Boble8080/Self-Balancing-Robot/encoderWaveform.png

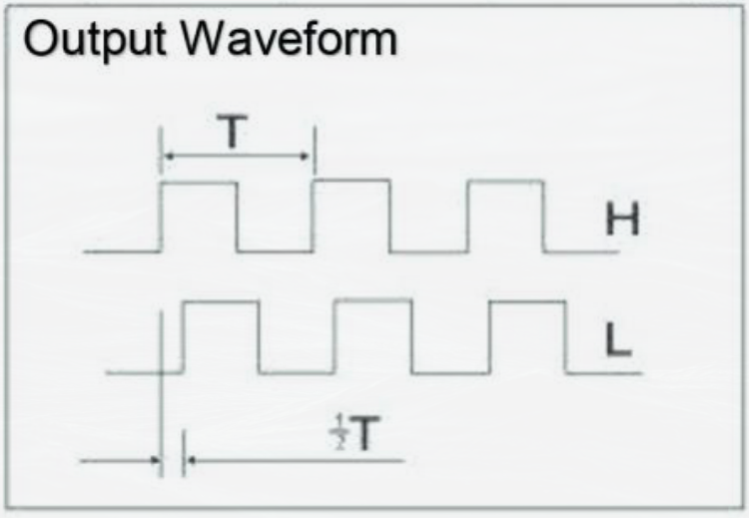
encoderWaveform.png
