Boble8080/Self-Balancing-Robot/GyroCal.png

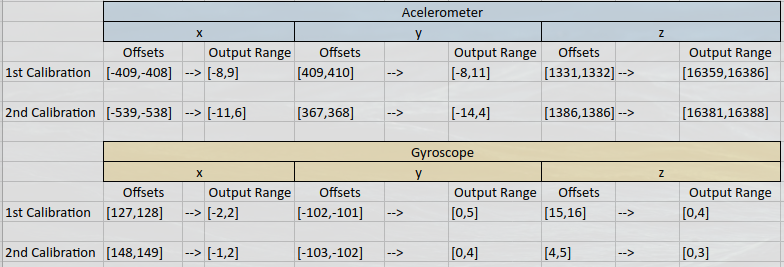
GyroCal.png
