Boble8080/Self-Balancing-Robot/Hbridge.png

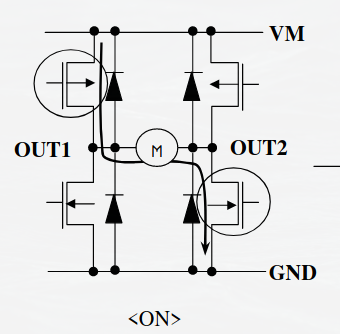
Hbridge.png
