Boble8080/Self-Balancing-Robot/pcb.png

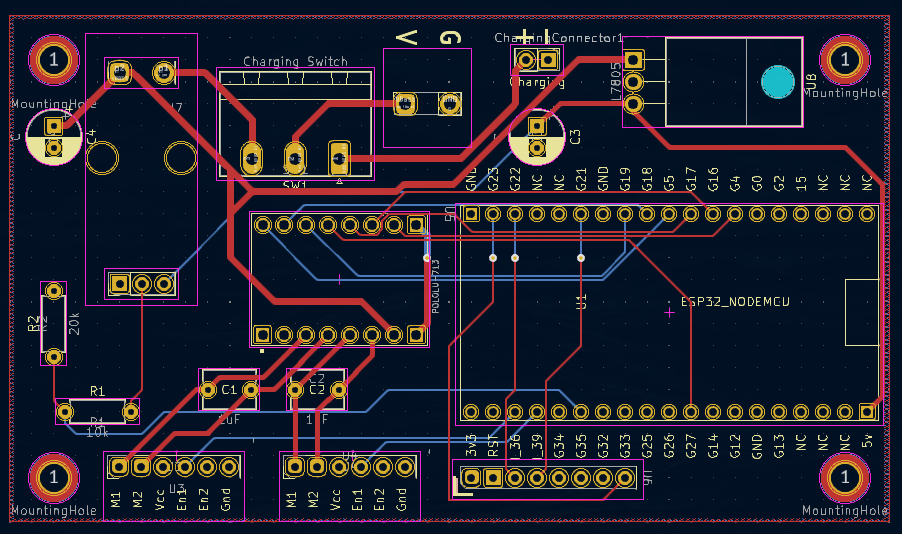
pcb.png
