Boble8080/Self-Balancing-Robot/Schematic.png

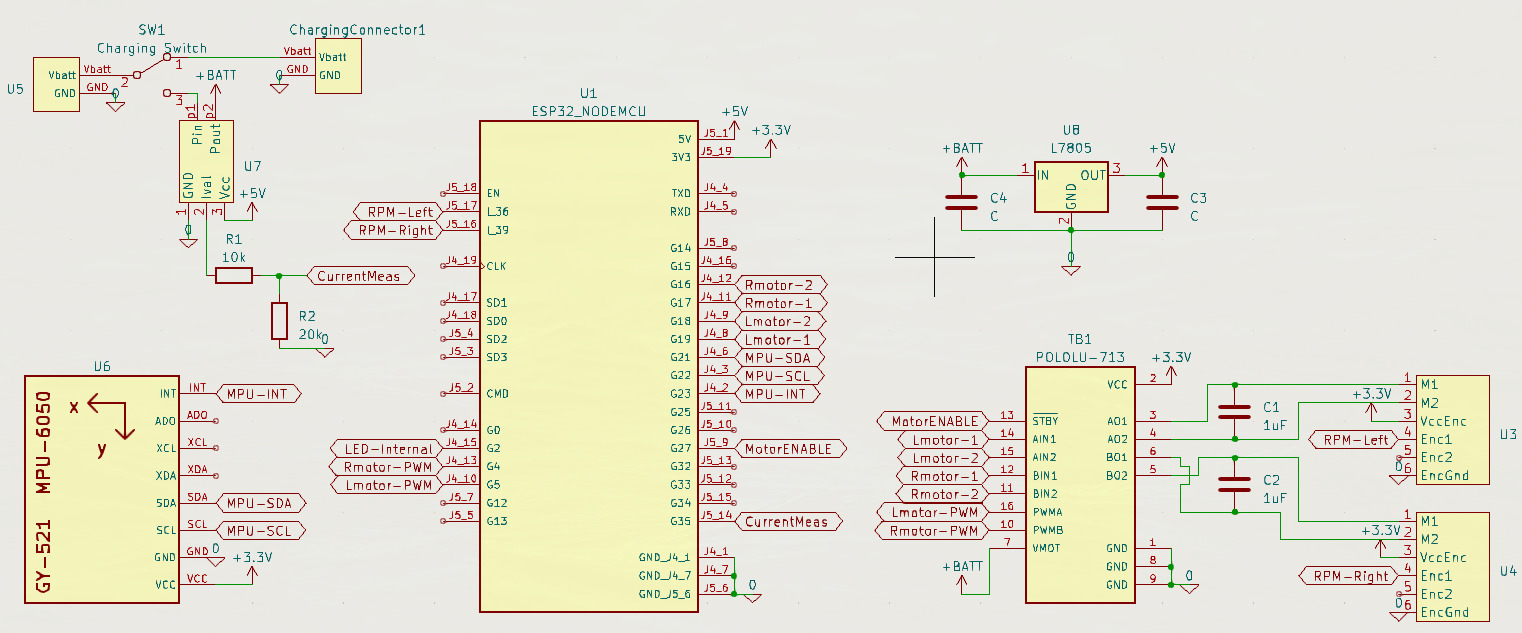
Schematic.png
