Boble8080/Self-Balancing-Robot/LtSpice/BatteryMonitorTest.asc

C1: cap; 1µ
R1: res; 10
R2: res; 500
R3: res; 100k
R4: res; 100k
U1: LT1762-5
V1: voltage; 4; Rser=0.3
V2: voltage; 4; Rser=0.3
Named nets: 0
;tran 0 5 0 0.001
.dc V1 4.2 2.7 -0.1
