Boble8080/Self-Balancing-Robot/LtSpice/BatteryMonitorTestv2.asc

LOAD: res; 10
R1: res; 100k
R2: res; 100k
V1: voltage; 4; Rser=0.3
V2: voltage; 4; Rser=0.3
Named nets: 0, Measurment
.dc V1 4.2 2.7 -0.1
