Boble8080/Self-Balancing-Robot/KiCad/SelfBalancingRobot/SelfBalancingRobot.kicad_pcb

## KiCad design KiCad/SelfBalancingRobot/SelfBalancingRobot.kicad_pcb (2023-04-20)

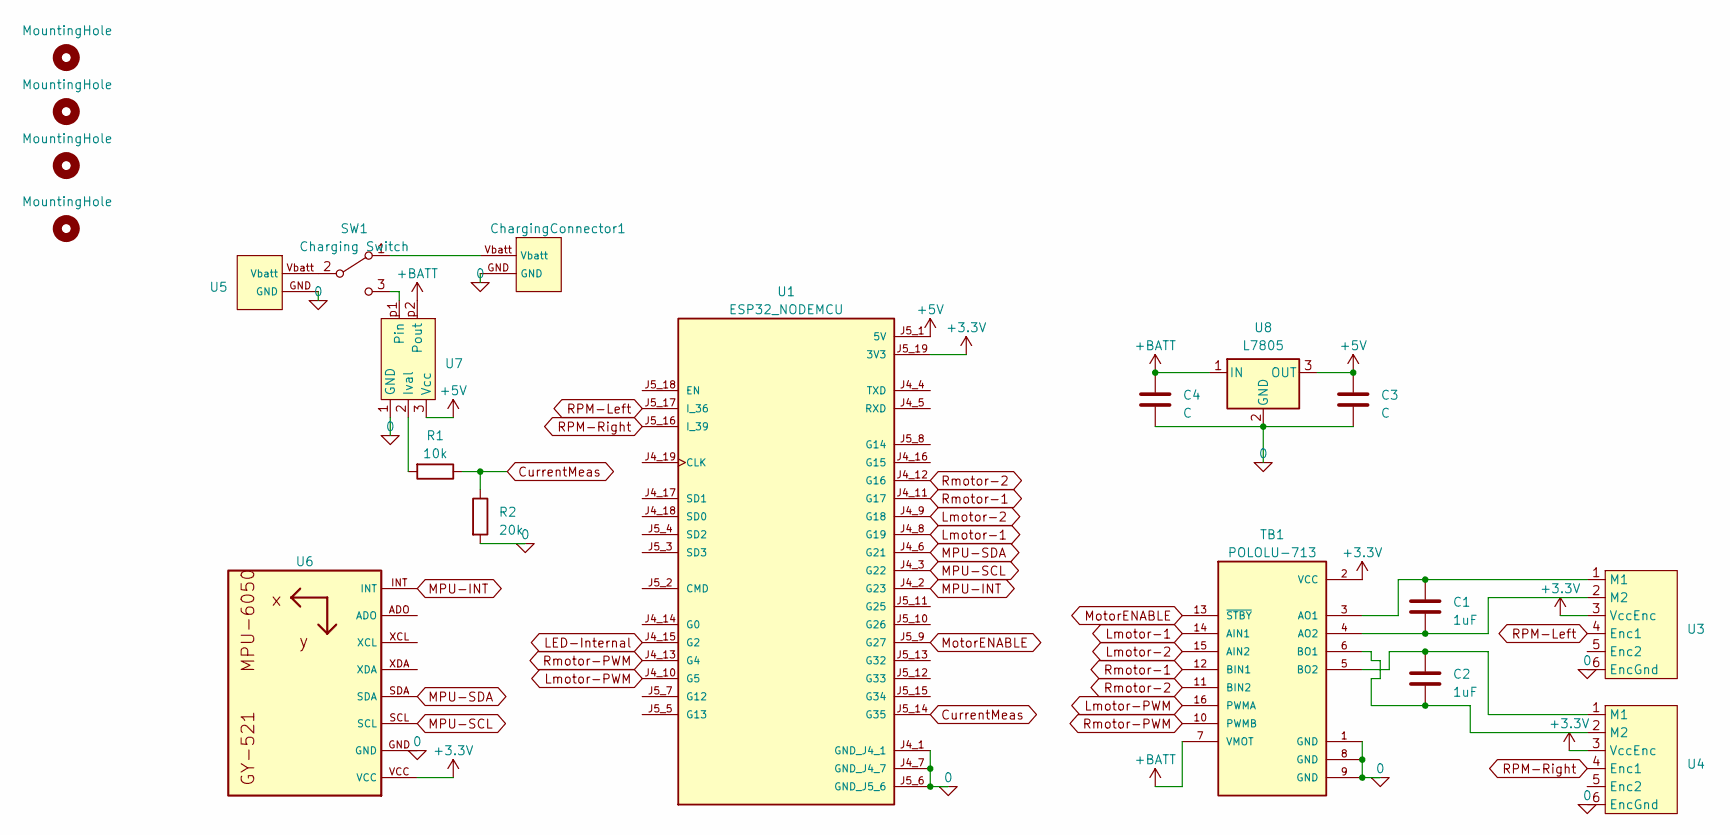
[picture p6: schematic SelfBalancingRobot.kicad_sch]

Parts:
C1, C2: 1uF; C_Disc_D6.0mm_W4.4mm_P5.00mm
C3, C4: C; CP_Radial_D6.3mm_P2.50mm
ChargingConnector1: ChargingConnector
H1, H2, H3, H4: MountingHole; MountingHole_3.2mm_M3_DIN965_Pad_TopBottom
R1: 10k; R_Axial_DIN0207_L6.3mm_D2.5mm_P7.62mm_Horizontal
R2: 20k; R_Axial_DIN0207_L6.3mm_D2.5mm_P7.62mm_Horizontal
SW1: Charging Switch; PhoenixContact_MSTBA_2,5_3-G-5,08_1x03_P5.08mm_Horizontal
TB1: POLOLU-713; SHIELD_POLOLU-713
U1: ESP32_NODEMCU; MODULE_ESP32_NODEMCU
U3, U4: V-TecMotorHeader
U5: BatteryConnector
U6: MPU-6050-External
U7: CurrentMeter
U8: L7805; TO-220-3_Horizontal_TabDown

Connections:
0: C3.2, C4.2, ChargingConnector1.GND, R2.2, TB1.1 (GND), TB1.8 (GND), TB1.9 (GND), U1.J4_1 (GND_J4_1), U1.J4_7 (GND_J4_7), U1.J5_6 (GND_J5_6), U3.6 (EncGnd), U4.6 (EncGnd), U5.GND, U6.GND, U7.1 (GND), U8.2 (GND)
+3.3V: TB1.2 (VCC), U1.J5_19 (3V3), U3.3 (VccEnc), U4.3 (VccEnc), U6.VCC
+5V: C3.1, U1.J5_1 (5V), U7.3 (Vcc), U8.3 (OUT)
+BATT: C4.1, TB1.7 (VMOT), U7.p2 (Pout), U8.1 (IN)
CurrentMeas: R1.1, R2.1, U1.J5_14 (G35)
LED-Internal: U1.J4_15 (G2)
Lmotor-1: TB1.14 (AIN1), U1.J4_8 (G19)
Lmotor-2: TB1.15 (AIN2), U1.J4_9 (G18)
Lmotor-PWM: TB1.16 (PWMA), U1.J4_10 (G5)
MPU-INT: U1.J4_2 (G23), U6.INT
MPU-SCL: U1.J4_3 (G22), U6.SCL
MPU-SDA: U1.J4_6 (G21), U6.SDA
MotorENABLE: TB1.13 (~STBY), U1.J5_9 (G27)
unnamed: ChargingConnector1.Vbatt, SW1.1 (A)
unnamed: SW1.2 (B), U5.Vbatt
unnamed: SW1.3 (C), U7.p1
unnamed: C1.1, TB1.3 (AO1), U3.1 (M1)
unnamed: C1.2, TB1.4 (AO2), U3.2 (M2)
unnamed: C2.2, TB1.6 (BO1), U4.2 (M2)
unnamed: C2.1, TB1.5 (BO2), U4.1 (M1)
unnamed: R1.2, U7.2 (Ival)
RPM-Left: U1.J5_17 (I_36), U3.4 (Enc1)
RPM-Right: U1.J5_16 (I_39), U4.4 (Enc1)
Rmotor-1: TB1.12 (BIN1), U1.J4_11 (G17)
Rmotor-2: TB1.11 (BIN2), U1.J4_12 (G16)
Rmotor-PWM: TB1.10 (PWMB), U1.J4_13 (G4)

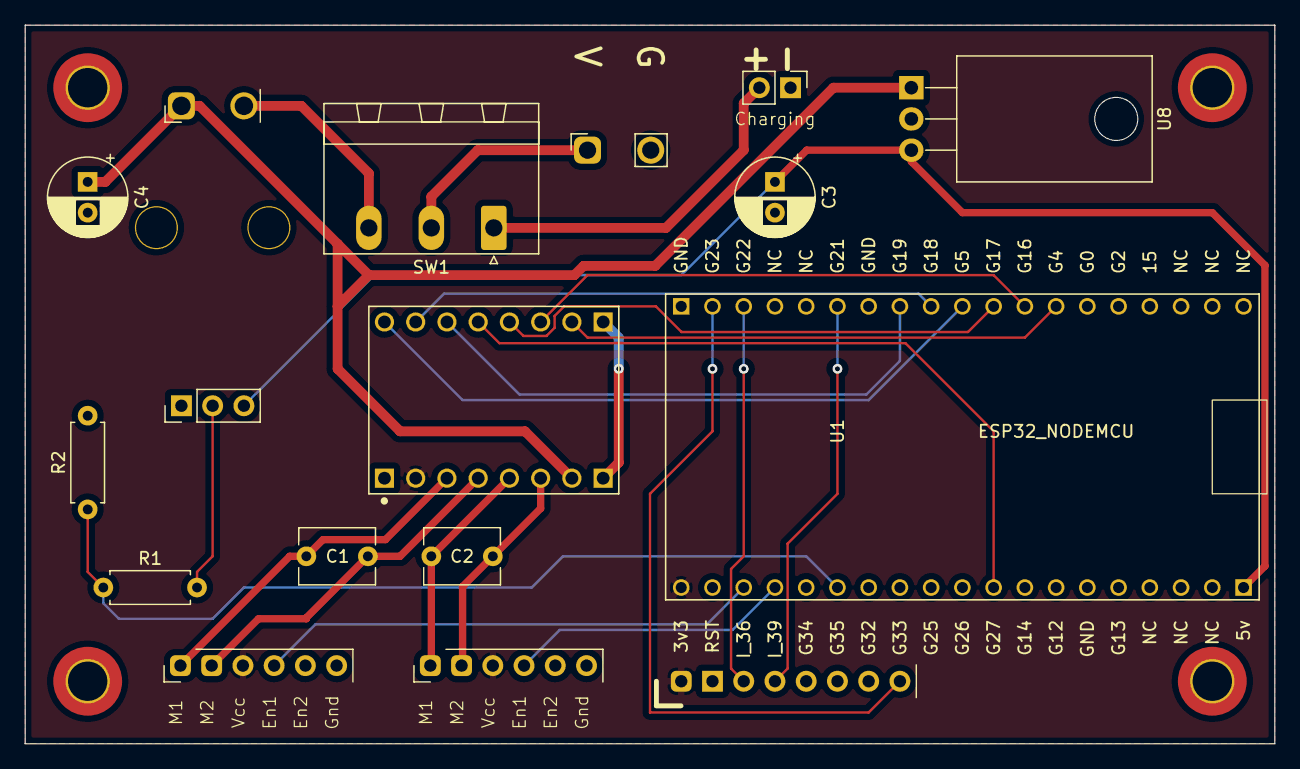
[picture p7: board SelfBalancingRobot.kicad_pcb from above]

Board: 2 copper layers, 101.6 x 58.4 mm, 20 parts (0 on the bottom side), 25 nets.
