Boble8080/Self-Balancing-Robot/Test1Data.xlsx

time | gyro | setpoint | output | cal | leftsteps | rightsteps | RPM | remote | gyro norm-dist | -5.9 | 0.01033154214
14:47:27 | -1.95 | 0 | -10.4 | 0 | 12 | -253 | 12.9 | 0 | 0.1195846913 | -5.9 | 0.01033154214
14:47:27 | -1.95 | 0 | -10.4 | 0 | 11 | -253 | 11.29 | 0 | 0.1195846913 | -5.9 | 0.01033154214 | time | 40 | s
14:47:27 | -2.72 | 0 | -3.24 | 0 | 10 | -255 | 166.87 | 0 | 0.09024944464 | -5.9 | 0.01123230287 | standard deviation | 2.499807573
14:47:27 | -2.72 | 0 | -3.24 | 0 | 8 | -255 | 164.98 | 0 | 0.09024944464 | -5.81 | 0.0139484656 | avarage | -0.05087608761
14:47:27 | -2.72 | 0 | -3.24 | 0 | 6 | -255 | 164.85 | 0 | 0.09024944464 | -5.57 | 0.0139484656
14:47:27 | -2.72 | 0 | -3.24 | 0 | 5 | -255 | 165.03 | 0 | 0.09024944464 | -5.57 | 0.0139484656
14:47:27 | -2.72 | 0 | -1.99 | 0 | 3 | -255 | 16.19 | 0 | 0.09024944464 | -5.57 | 0.0139484656
14:47:27 | -3.48 | 0 | 5.47 | 0 | 3 | -255 | 16.19 | 0 | 0.06228663596 | -5.57 | 0.01419658467
14:47:27 | -3.48 | 0 | 5.47 | 0 | 3 | -255 | 16.19 | 0 | 0.06228663596 | -5.55 | 0.01419658467
14:47:27 | -3.48 | 0 | 5.47 | 0 | 3 | -255 | 16.19 | 0 | 0.06228663596 | -5.55 | 0.01419658467
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
