Boble8080/Self-Balancing-Robot/(commit log)

2023-03-27 motor test and step
2023-03-28 ltspice battery test
2023-04-04 newMPU and 2 motors
2023-04-11 encoder double code
2023-04-17 kicad parts
    [SelfBalancingRobot.kicad_pcb, SelfBalancingRobot.kicad_sch]
2023-04-18 kicad layout finished1
    [SelfBalancingRobot.kicad_pcb, SelfBalancingRobot.kicad_sch]
2023-04-20 kicad done and pid integrated
    [SelfBalancingRobot-B_Cu.gbl, SelfBalancingRobot-B_Mask.gbs, SelfBalancingRobot-B_Silkscreen.gbo, SelfBalancingRobot-Edge_Cuts.gm1, SelfBalancingRobot-F_Cu.gtl, SelfBalancingRobot-F_Mask.gts, SelfBalancingRobot-F_Silkscreen.gto, SelfBalancingRobot-NPTH.drl]
2023-04-20 Working PID
2023-05-05 kicad zip
